wagiminator/ATtiny13-TinyUPS/documentation/TinyUPS_perf1.png

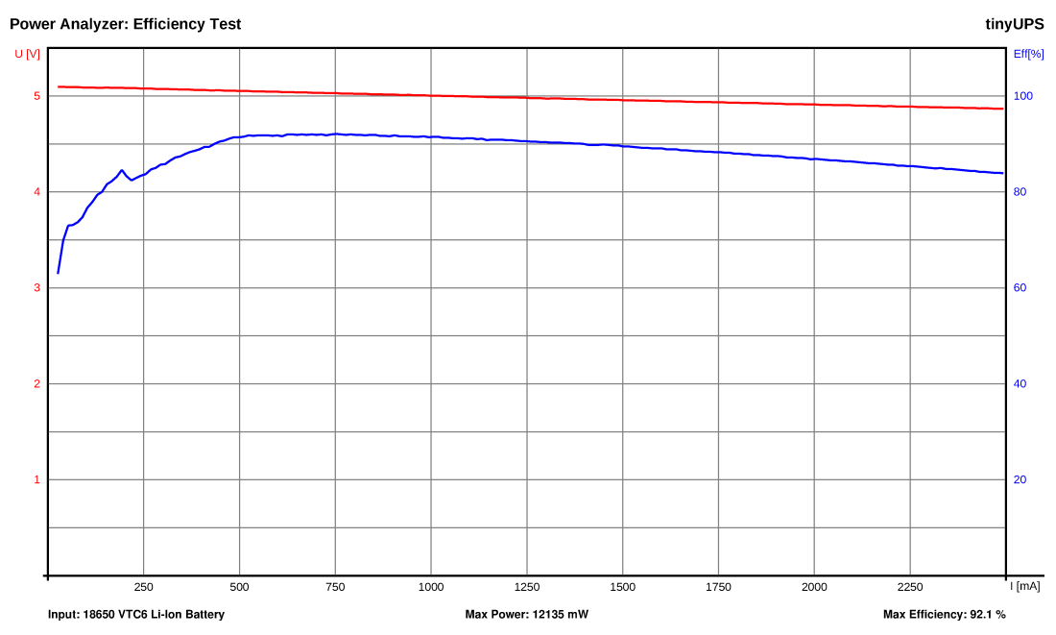
documentation/TinyUPS_perf1.png
