wagiminator/ATtiny13-TinyUPS/documentation/TinyUPS_perf2.png

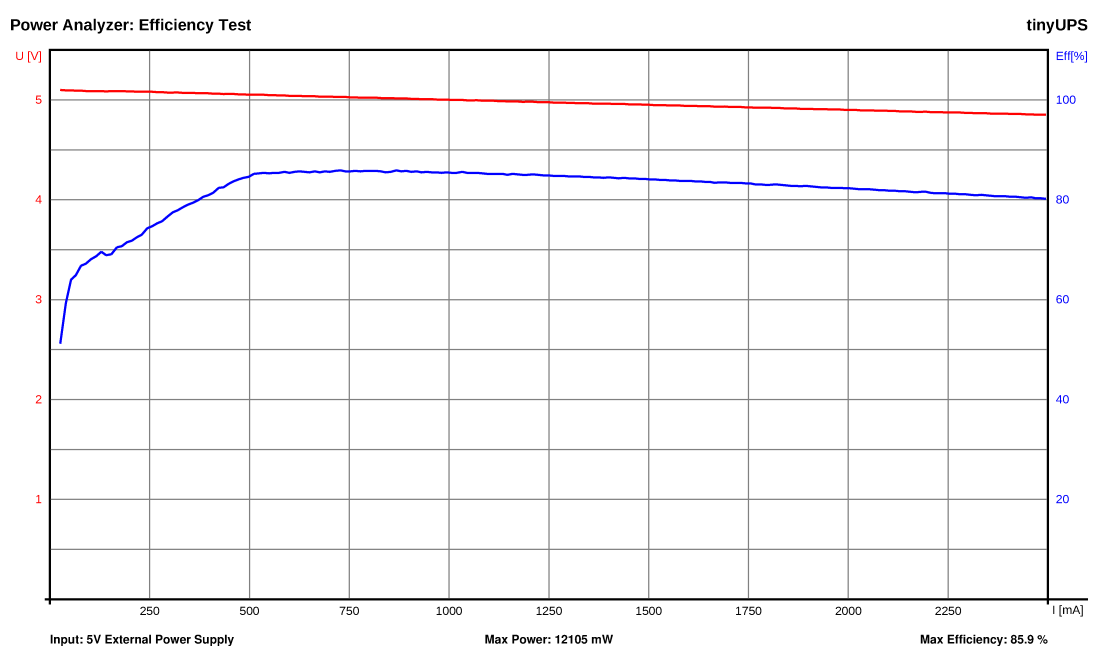
documentation/TinyUPS_perf2.png
