wagiminator/ATtiny13-TinyUPS/documentation/TinyUPS_pic4.jpg

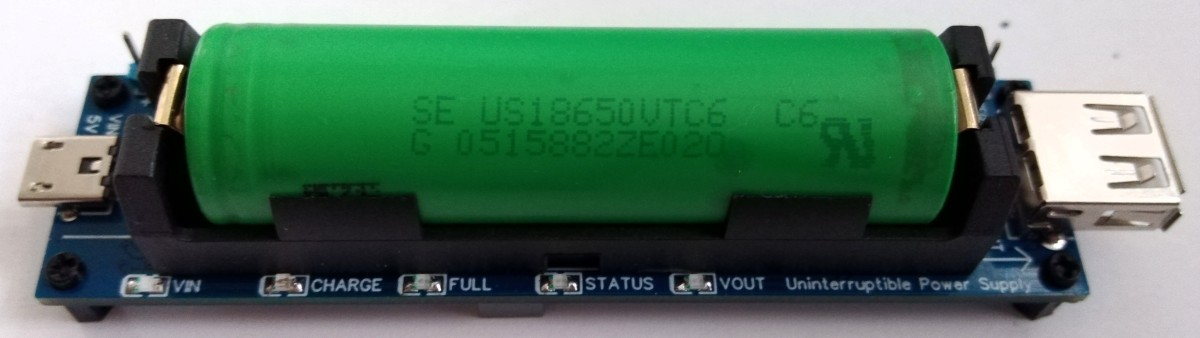
documentation/TinyUPS_pic4.jpg
