wagiminator/ATtiny13-TinyUPS/documentation/TinyUPS_scope1.png

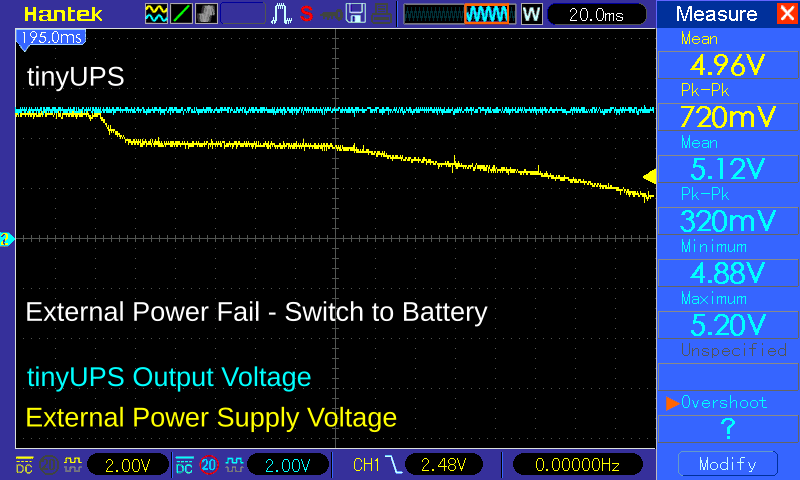
documentation/TinyUPS_scope1.png
