wagiminator/ATtiny13-TinyUPS/documentation/TinyUPS_scope2.png

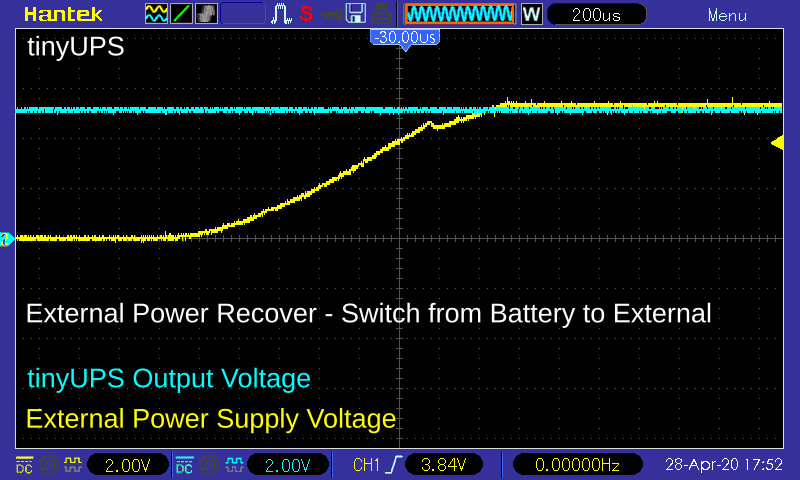
documentation/TinyUPS_scope2.png
