wagiminator/ATtiny13-TinyUPS/documentation/TinyUPS_scope3.png

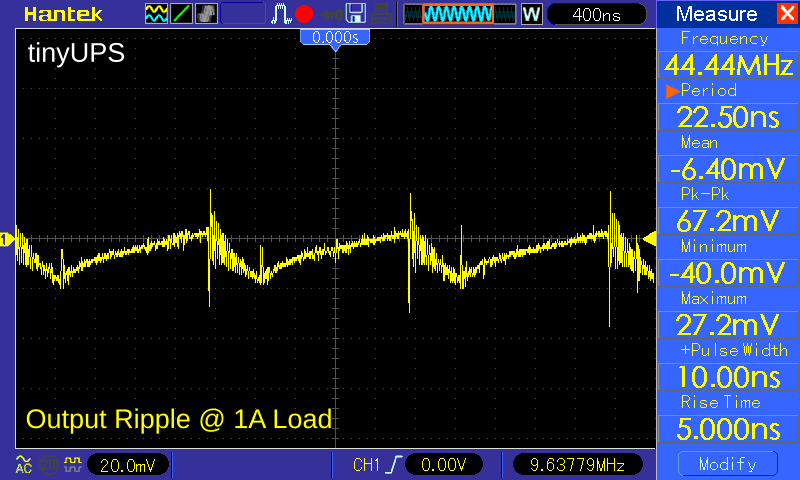
documentation/TinyUPS_scope3.png
