wagiminator/ATtiny13-TinyUPS/hardware/TinyUPS_BOM.tsv

ID | Name | Designator | Footprint | Quantity | Manufacturer Part | Manufacturer | Supplier | Supplier Part
1 | Connector | BAT,COM,VOUT,VIN | HDR-1X2/2.54 | 4 | 2.54-1*2PFemale | BOOMELE | LCSC | C49661
2 | 3904 | Q4,Q3 | SOT-23_1 | 2 | 2n3904S-RTK/PS | KEC | LCSC | C18536
3 | 3.3uH | L1 | IND-SMD_L7.8-W7.0_0630 | 1 | JSHC0650H-3R3M-G | Jinlai | LCSC | C334093
4 | 100n | C1,C3,C7 | 805 | 3 | CC0805KRX7R9BB104 | YAGEO | LCSC | C49678
5 | 1u | C8 | 805 | 1 | CL21B105KBFNNNE | SAMSUNG | LCSC | C28323
6 | 100u | C6 | 1206 | 1 | CL31A107MPHNNNE | SAMSUNG | LCSC | C52922
7 | 22u | C5,C4 | 805 | 2 | CL21A226MAQNNNE | SAMSUNG | LCSC | C45783
8 | 10u | C2 | 805 | 1 | CL21A106KAYNNNE | SAMSUNG | LCSC | C15850
9 | 18650 Holder | U5 | 18650-HOLDER | 1 | BH-18650-B1BA002 | MYOUNG | LCSC | C2988620
10 | POWER OUT | USB2 | USB-2.0-A-F-90-JCJ-H9.36 | 1 | USB-A-F-90 | LCSC | LCSC | C168708
11 | DMP1045U-7 | Q5,Q6 | SOT-23-3_L2.9-W1.3-P1.90-LS2.4-BR | 2 | DMP1045U-7 | Diodes Incorporated | LCSC | C177033
12 | TS24CA | KEY | SW-SMD_TS24CA | 1 | TS24CA | SHOU HAN | LCSC | C393942
13 | POWER IN | USB1 | USB PWR CONNECTOR | 1 | KH-MICRO-SMT.J-2P | Shenzhen Kinghelm Elec | LCSC | C2688799
14 | ICSP-PADS | ICSP | ICSP-PADS-SMALL | 1 | C37208 | BOOMELE | LCSC | C37208
15 | 1k | R9,R2,R1,R13,R10,R4,R15,R14 | 805 | 8 | 0805W8F1001T5E | UniOhm | LCSC | C17513
16 | 1k2 | R3 | 805 | 1 | 0805W8F1201T5E | UniOhm | LCSC | C17379
17 | 39k | R18 | 805 | 1 | 0805W8F3902T5E | UniOhm | LCSC | C25826
18 | 10k | R17,R11,R12,R16,R8 | 805 | 5 | 0805W8F1002T5E | UniOhm | LCSC | C17414
19 | 100R | R5 | 805 | 1 | 0805W8F1000T5E | UniOhm | LCSC | C17408
20 | 33k | R6 | 805 | 1 | 0805W8F3302T5E | UniOhm | LCSC | C17633
21 | 75k | R7 | 805 | 1 | 0805W8F7502T5E | UniOhm | LCSC | C17819
22 | DW01A | U2 | SOT-23-6 | 1 | DW01A | FM | LCSC | C85680
23 | FP6277XR-G1 | U3 | SOP-8_EP_150MIL | 1 | FP6277XR-G1 | Feeling Technology | LCSC | C88312
24 | CHRG | LED2 | LED-0805 | 1 | FC-2012HRK-620D | NATIONSTAR | LCSC | C84256
25 | FS8205 | Q2,Q1 | SOT-23-6 | 2 | FS8205 | FORTUNE | LCSC | C32254
26 | STATUS | LED5 | LED-0805 | 1 | 17-21/GHC-XS1T2M/3T | EVERLIGHT | LCSC | C63855
27 | VOUT | LED4 | LED-0805 | 1 | 17-21/BHC-XL2M2TY/3T | EVERLIGHT | LCSC | C72035
28 | VIN | LED3 | LED-0805 | 1 | 17-21/BHC-XL2M2TY/3T | EVERLIGHT | LCSC | C72035
29 | FULL | LED1 | LED-0805 | 1 | 17-21/GHC-XS1T2M/3T | EVERLIGHT | LCSC | C63855
30 | TP4056 | U1 | SOP-8_EP_150MIL | 1 | TP4056 | TOPPOWER | LCSC | C16581
31 | SS54 | D1 | DIODE-SMA(DO-214AC) | 1 | SS54 | Jingdao | LCSC | C123946
32 | ATTINY13A-SSU | U4 | SOP-8_150MIL | 1 | ATTINY13A-SSU | MICROCHIP | LCSC | C14075
