wagiminator/ATtiny13-TinyUPS/hardware/TinyUPS_schematic.pdf

Battery Charger | Battery Protection

## Power Connectors

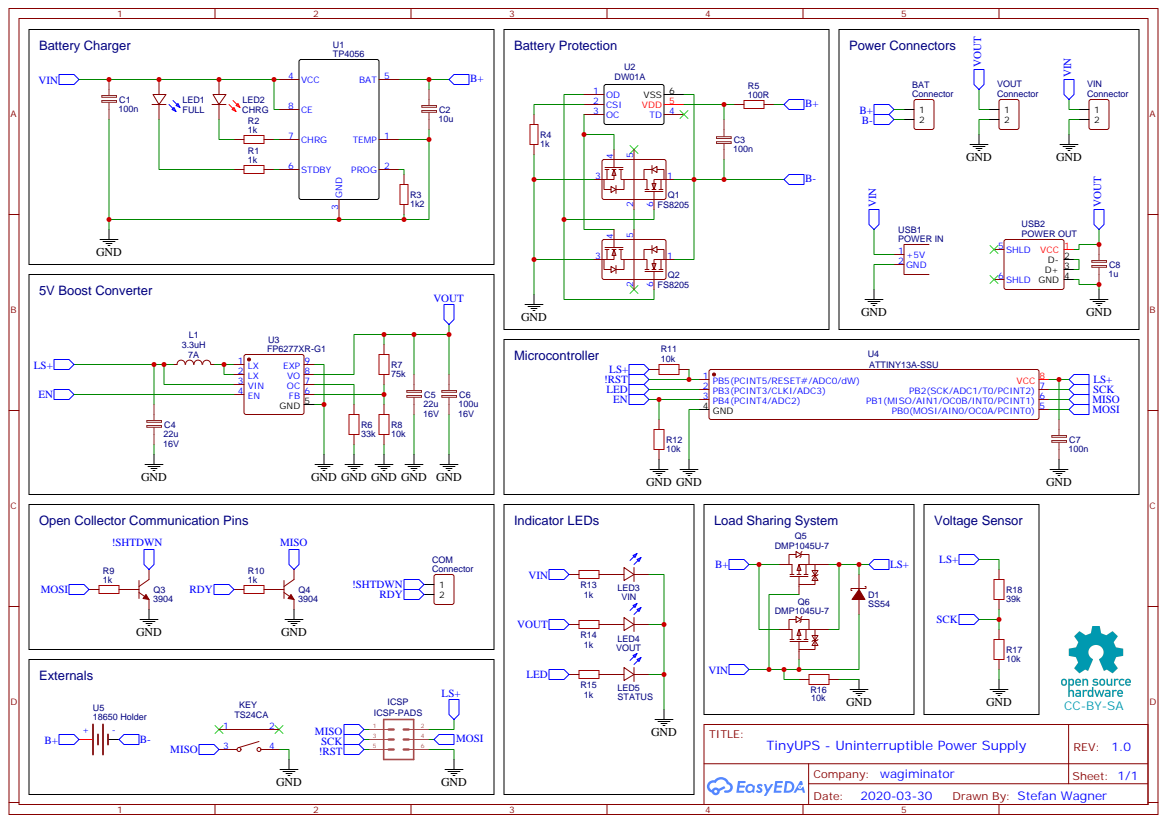
[picture p11: page 1]

Open Collector Communication Pins

Drawn By: Stefan Wagner
