wagiminator/ATtiny13-TinyUPS/(threads)

Thread 1 (2021-12-01):

Raspberry Pi files?

jmfloyd, 2021-12-01:
Stefan,

Your readme suggests that there should be some RaspberryPi scripts to monitor the UPS and an install shell script to set them up.  They seem to have been lost.

I followed your advice to get the board(s) made and mostly populated.  Nearly ready to test the setup.

Cheers
John

wagiminator, 2021-12-01:
Hi John,
oops, you're right. I have no idea how that happened. I uploaded the scripts again.
Greetings, Stefan

jmfloyd, 2021-12-01:
Thanks JohnOn Dec 1, 2021 4:21 PM, Stefan Wagner ***@***.***> wrote:
Hi John,
oops, you're right. I have no idea how that happened. I uploaded the scripts again.
Greetings, Stefan

—You are receiving this because you authored the thread.Reply to this email directly, view it on GitHub, or unsubscribe.Triage notifications on the go with GitHub Mobile for iOS or Android.

Closed 2021-12-01.

Thread 3 (2022-12-27):

Restart automatically raspberry

wojciewa, 2022-12-27:
Hi,
has your UPS capability to start Raspberry Pi when power supply works again?

wagiminator, 2022-12-28:
Hi, yes.
