wagiminator/ATtiny13-TinyUPS/(commit log)

2020-06-28 New board version
2020-11-18 Update files
    [TinyUPS_BOM_v1.0.tsv]
2021-10-31 Editorial changes
    [TinyUPS_BOM.tsv]
2022-09-10 Update BOM
    [TinyUPS_BOM.tsv]
